Gacathon/LeeChee_Mirror/README.md

# Lisence

CC BY-NC-SA 3.0

# LeeChee_Mirror
Cherry G80&amp;G81-1800 Keyboard layout.Almost both sides place switch.

# Recommend
Please read Readme.docx before assembling.
