Gacathon/LeeChee_Mirror/1800.kicad_pcb

## KiCad design 1800.kicad_pcb (2017-11-04)

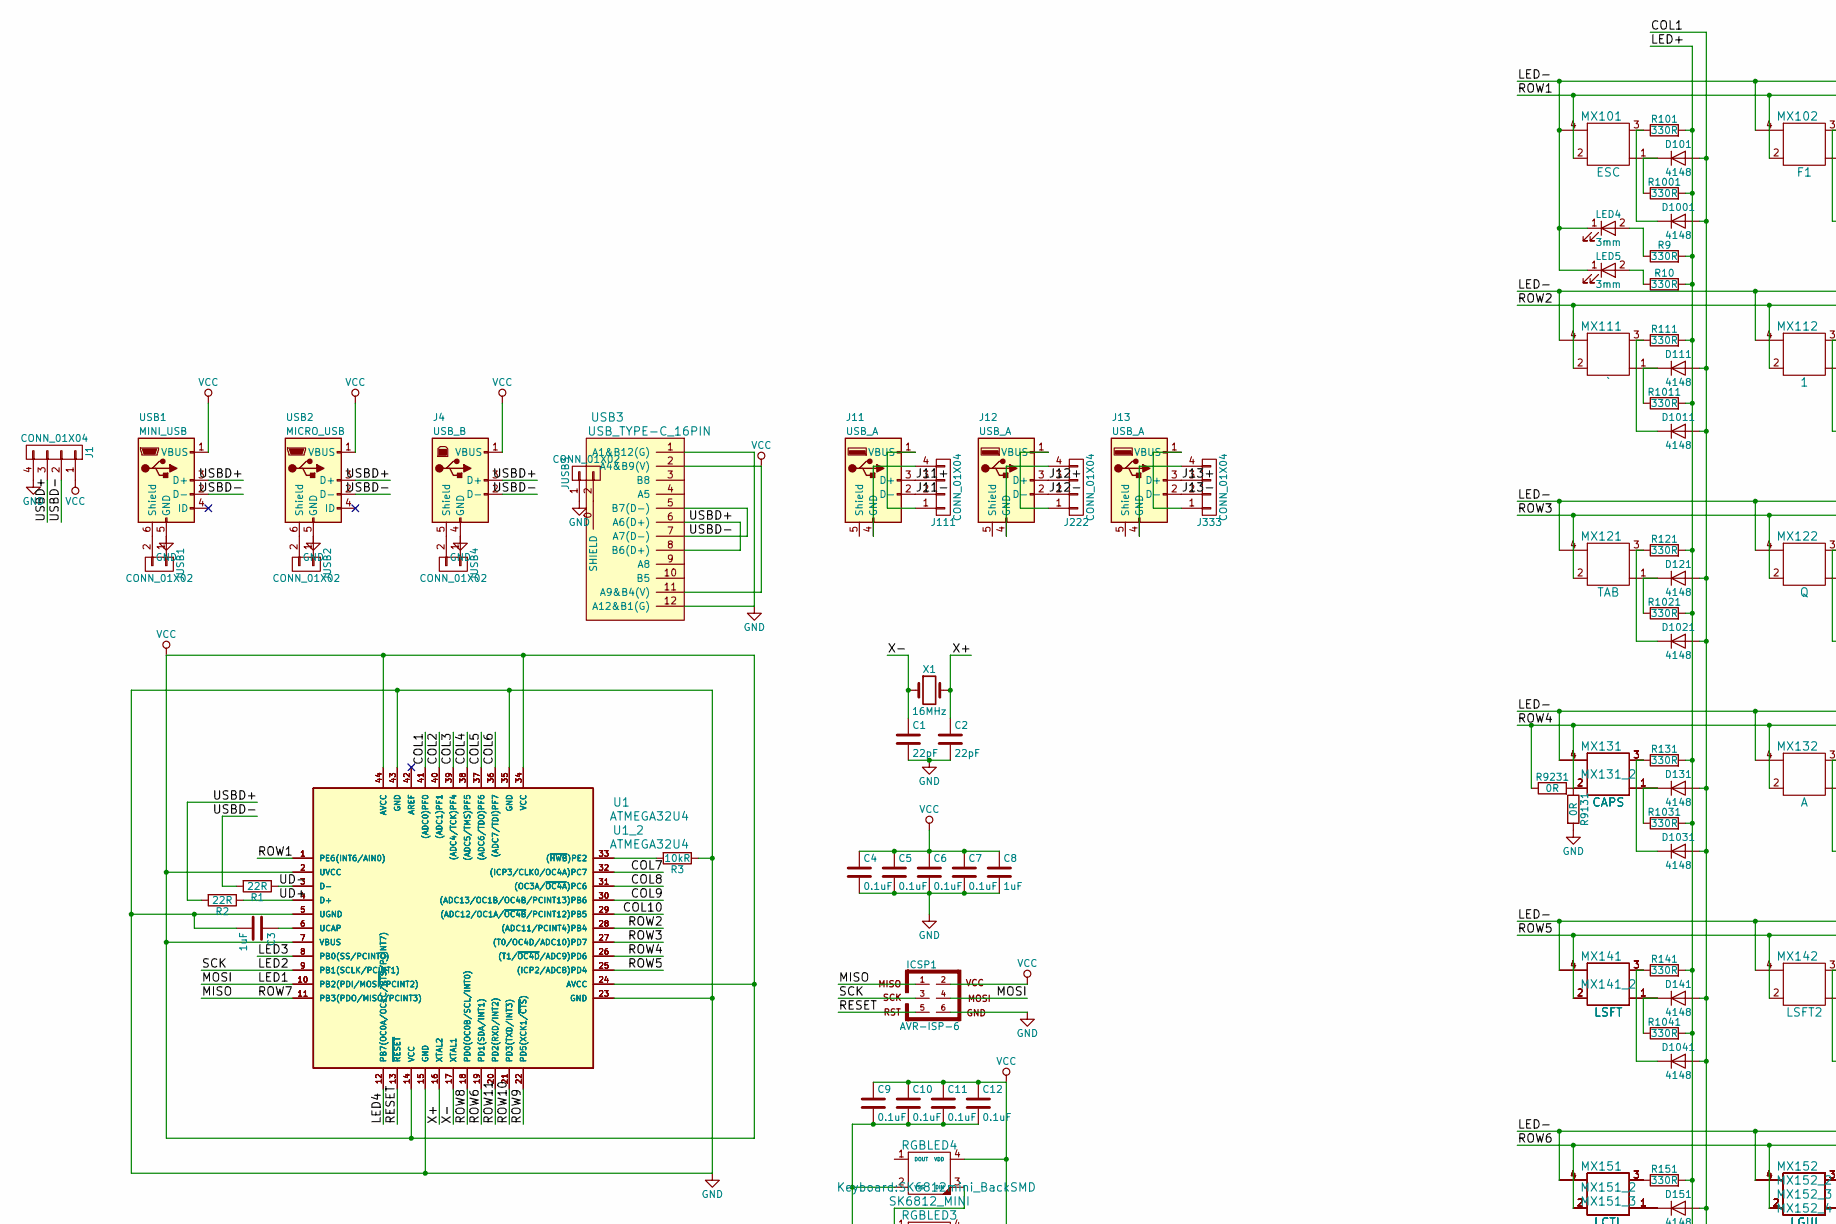
[picture p12: schematic 1800.sch, part in row 1, column 1]

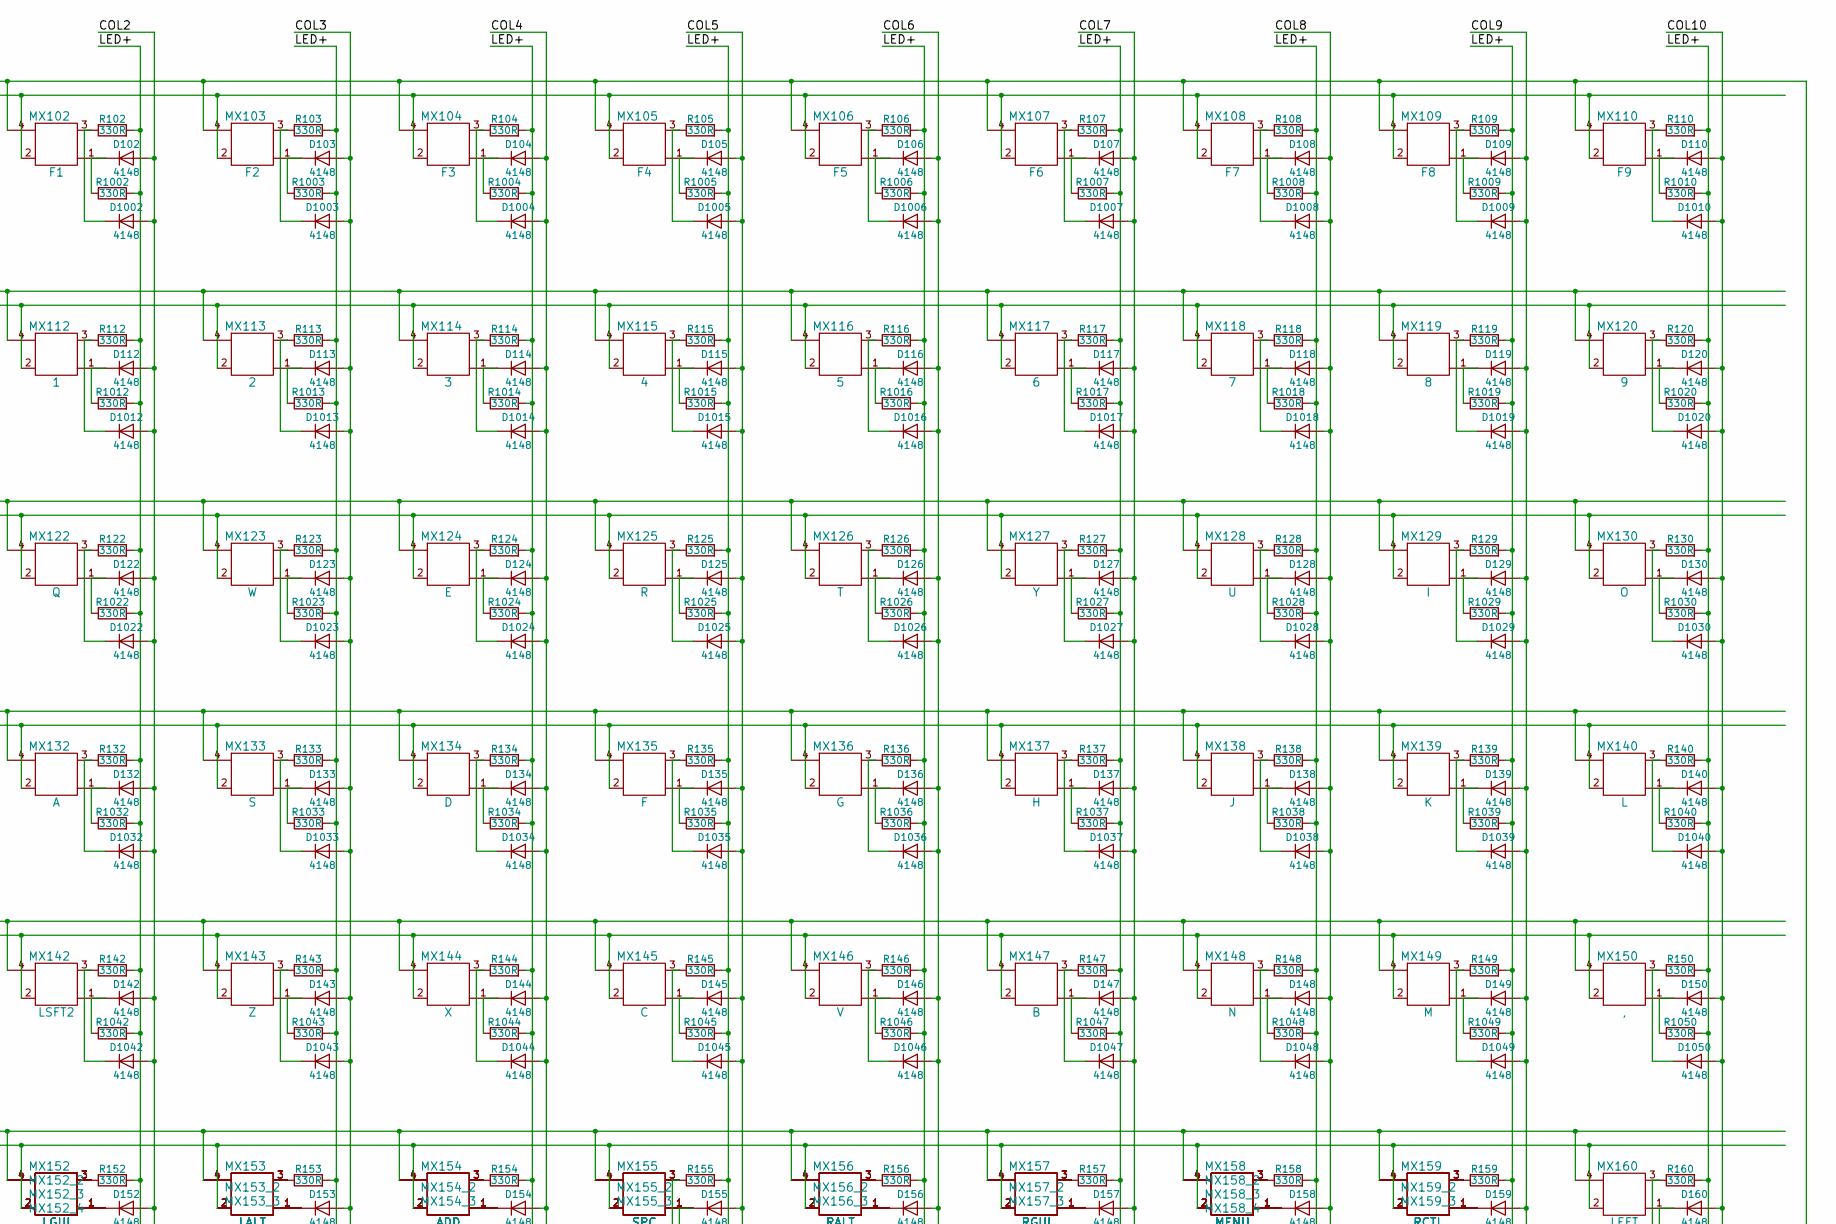
[picture p13: schematic 1800.sch, part in row 1, column 2]

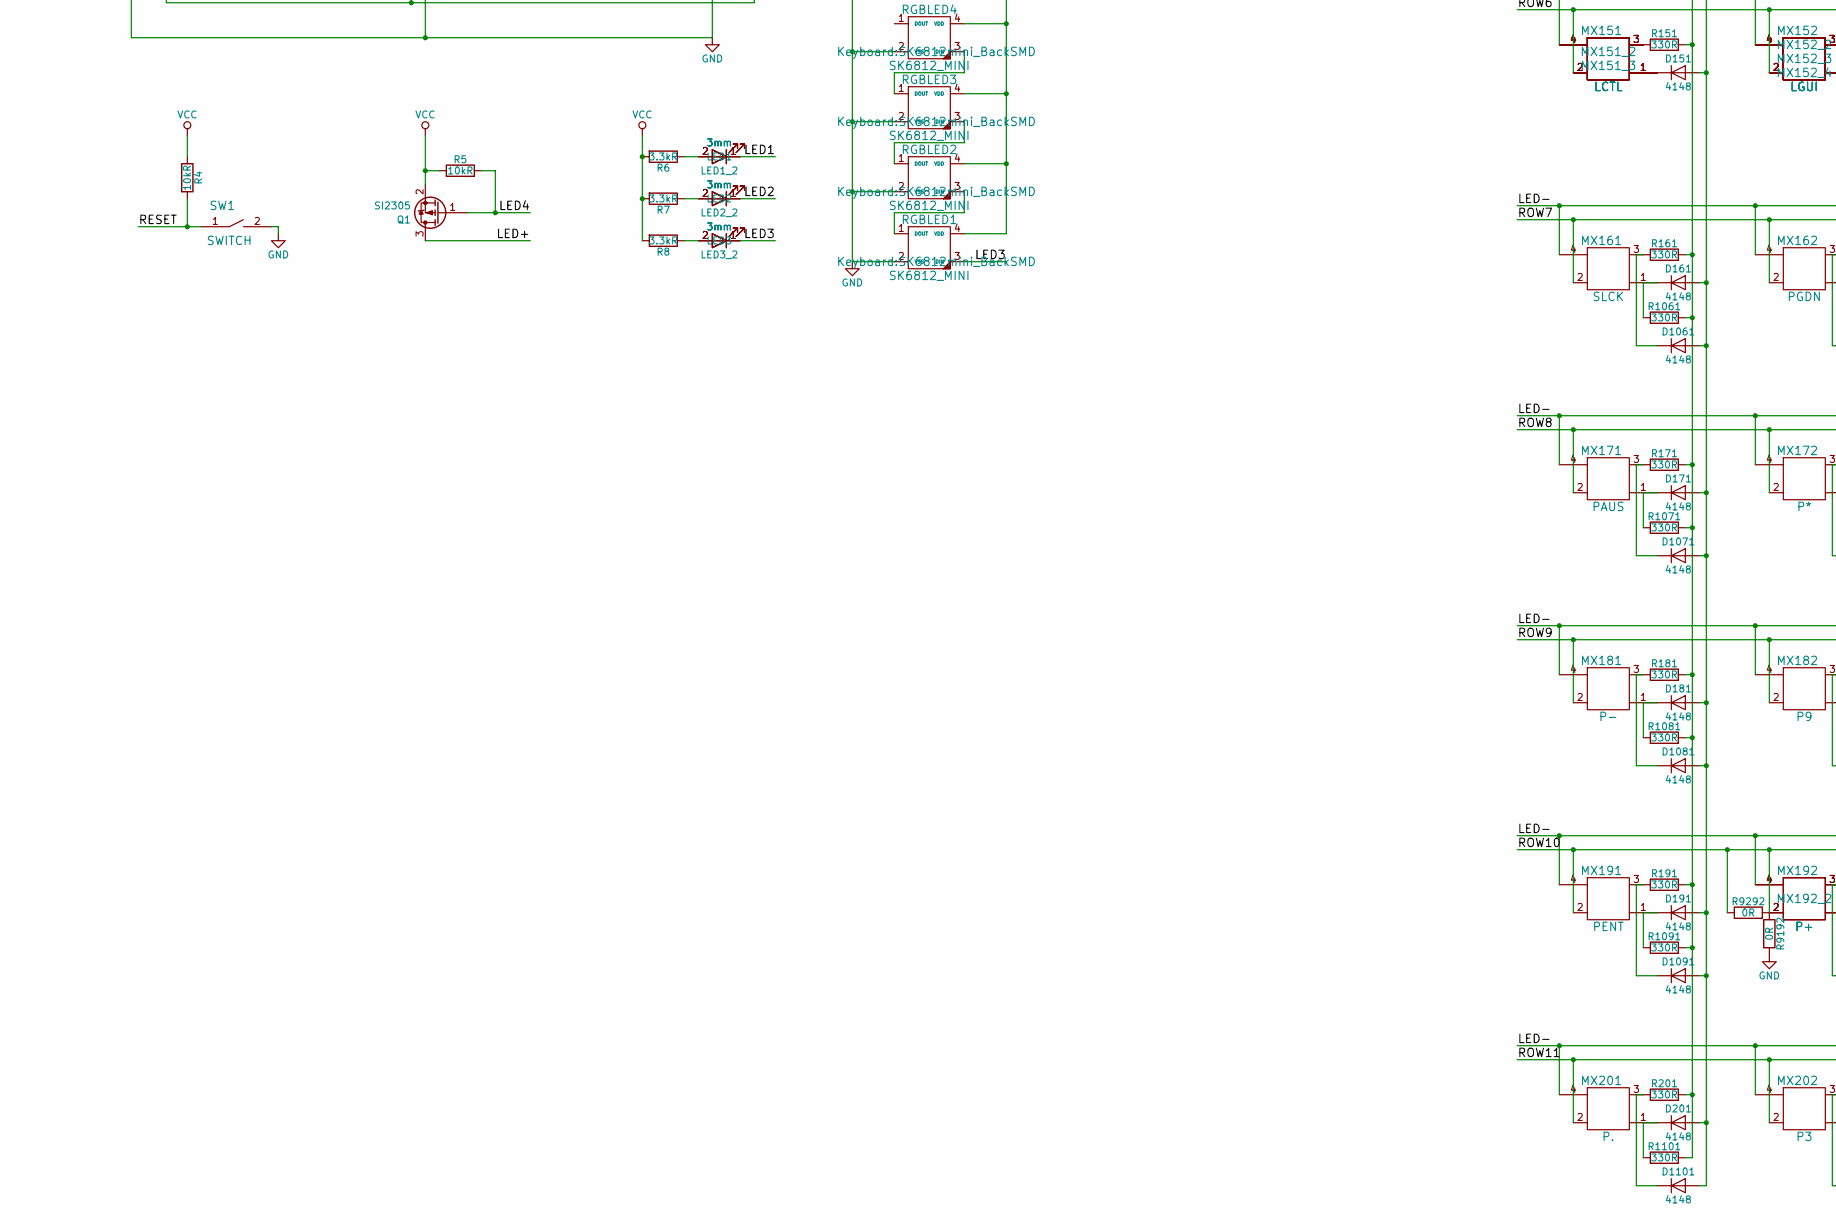
[picture p14: schematic 1800.sch, part in row 2, column 1]

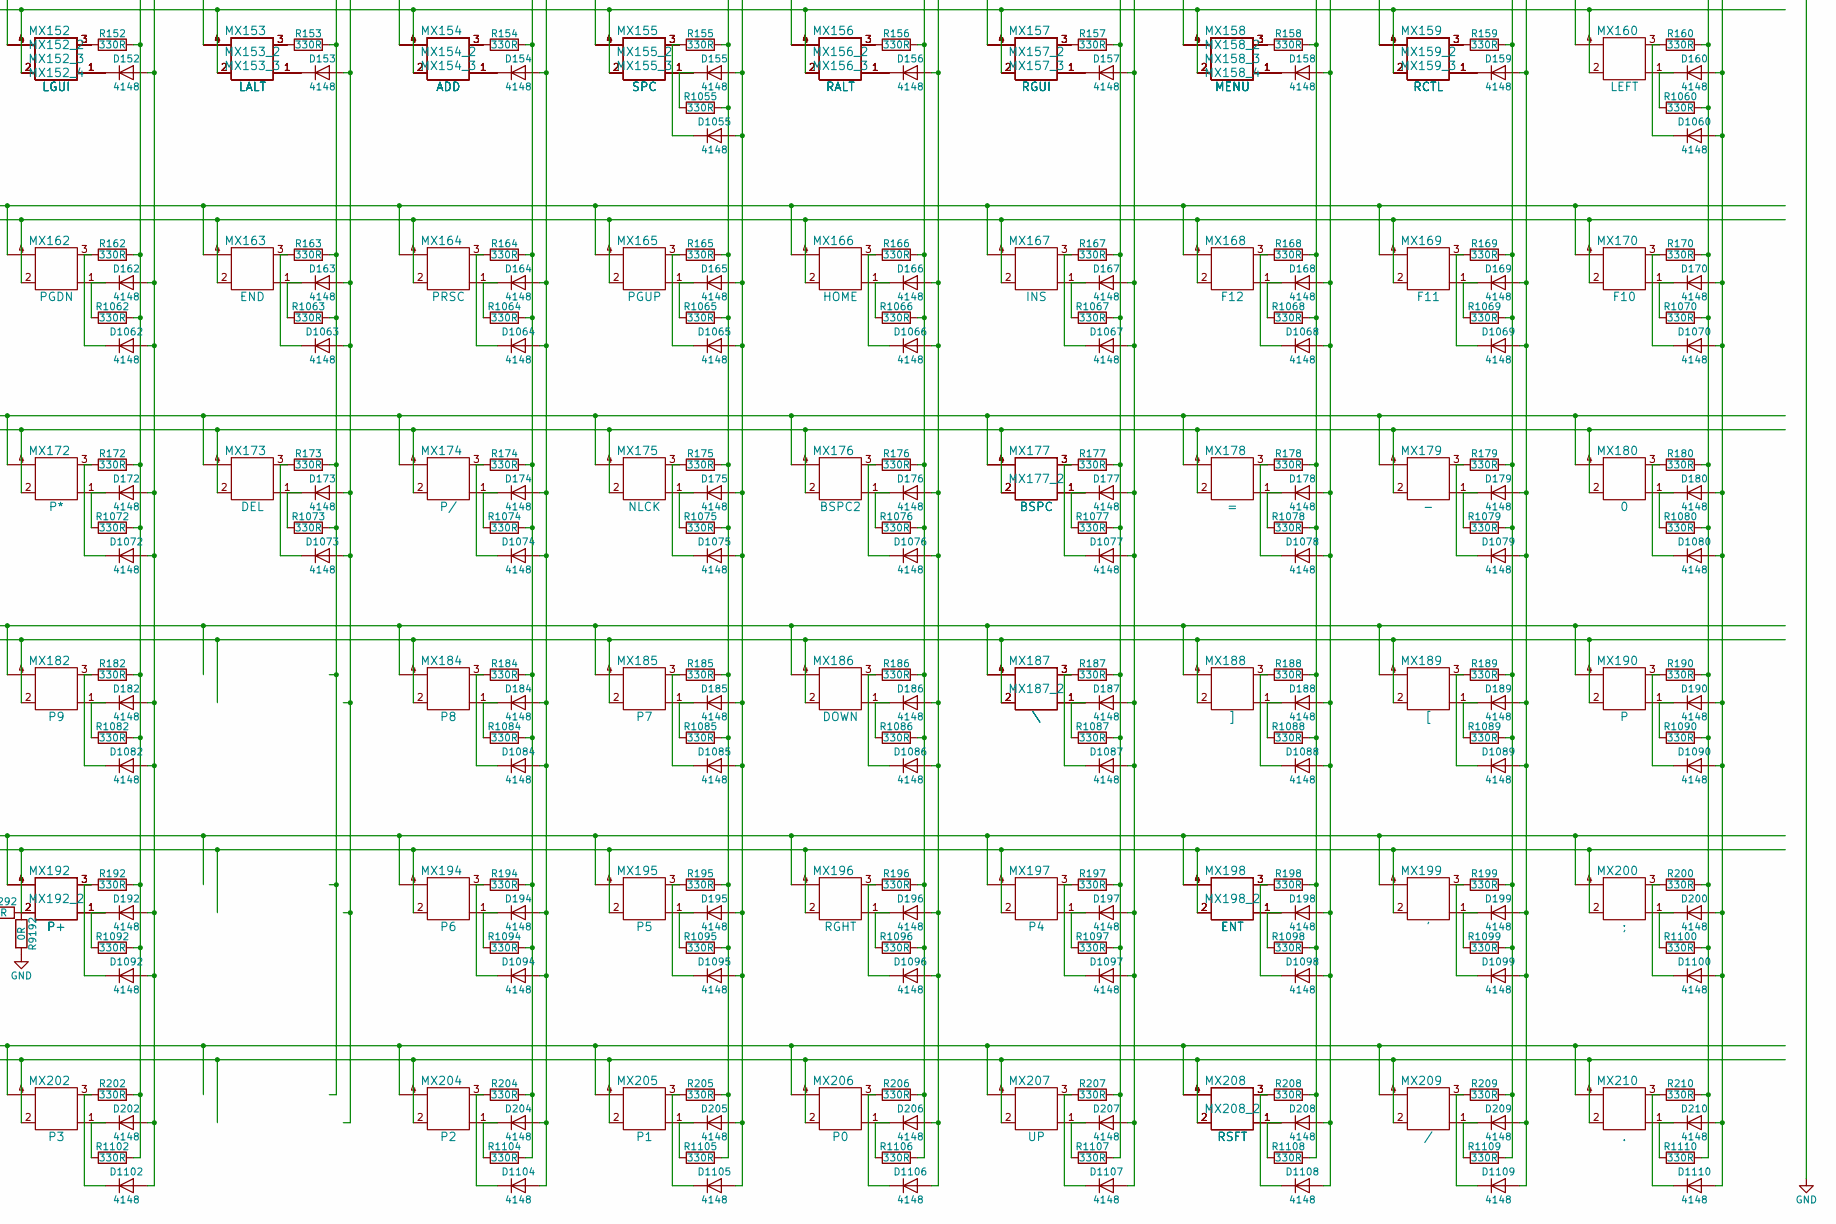
[picture p15: schematic 1800.sch, part in row 2, column 2]

Parts:
C1, C2: 22pF; C_0805
C3, C8: 1uF; C_0805
C4, C5, C6, C7, C9, C10, C11, C12: 0.1uF; C_0805
D101, D102, D103, D104, D105, D106, D107, D108, D109, D110, D111, D112, D113, D114, D115, D116, D117, D118, D119, D120, D121, D122, D123, D124, D125, D126, D127, D128, D129, D130, D131, D132, D133, D134, D135, D136, D137, D138, D139, D140, D141, D142, D143, D144, D145, D146, D147, D148, D149, D150, D151, D152, D153, D154, D155, D156, D157, D158, D159, D160, D161, D162, D163, D164, D165, D166, D167, D168, D169, D170, D171, D172, D173, D174, D175, D176, D177, D178, D179, D180, D181, D182, D184, D185, D186, D187, D188, D189, D190, D191, D192, D194, D195, D196, D197, D198, D199, D200, D201, D202, D204, D205, D206, D207, D208, D209, D210, D1001, D1002, D1003, D1004, D1005, D1006, D1007, D1008, D1009, D1010, D1011, D1012, D1013, D1014, D1015, D1016, D1017, D1018, D1019, D1020, D1021, D1022, D1023, D1024, D1025, D1026, D1027, D1028, D1029, D1030, D1031, D1032, D1033, D1034, D1035, D1036, D1037, D1038, D1039, D1040, D1041, D1042, D1043, D1044, D1045, D1046, D1047, D1048, D1049, D1050, D1055, D1060, D1061, D1062, D1063, D1064, D1065, D1066, D1067, D1068, D1069, D1070, D1071, D1072, D1073, D1074, D1075, D1076, D1077, D1078, D1079, D1080, D1081, D1082, D1084, D1085, D1086, D1087, D1088, D1089, D1090, D1091, D1092, D1094, D1095, D1096, D1097, D1098, D1099, D1100, D1101, D1102, D1104, D1105, D1106, D1107, D1108, D1109, D1110: 4148; D_0805
ICSP1: AVR-ISP-6; Pin_Header_Straight_2x03_Pitch2.54mm
J1, J111, J222, J333: CONN_01X04; Pin_Header_Straight_1x04_Pitch2.54mm
J4: USB_B
J11, J12, J13: USB_A; USB_A_2
JUSB1, JUSB2, JUSB3, JUSB4: CONN_01X02; Pin_Header_Straight_1x02_Pitch1.27mm
LED1, LED1_2, LED2, LED2_2, LED3, LED3_2, LED4, LED5: 3mm; LED_D3.0mm
MX101: ESC; MX1A&LEDx2
MX102: F1; MX1A&LEDx2
MX103: F2; MX1A&LEDx2
MX104: F3; MX1A&LEDx2
MX105: F4; MX1A&LEDx2
MX106: F5; MX1A&LEDx2
MX107: F6; MX1A&LEDx2
MX108: F7; MX1A&LEDx2
MX109: F8; MX1A&LEDx2
MX110: F9; MX1A&LEDx2
MX111: `; MX1A&LEDx2
MX112: 1; MX1A&LEDx2
MX113: 2; MX1A&LEDx2
MX114: 3; MX1A&LEDx2
MX115: 4; MX1A&LEDx2
MX116: 5; MX1A&LEDx2
MX117: 6; MX1A&LEDx2
MX118: 7; MX1A&LEDx2
MX119: 8; MX1A&LEDx2
MX120: 9; MX1A&LEDx2
MX121: TAB; MX1A&LEDx2
MX122: Q; MX1A&LEDx2
MX123: W; MX1A&LEDx2
MX124: E; MX1A&LEDx2
MX125: R; MX1A&LEDx2
MX126: T; MX1A&LEDx2
MX127: Y; MX1A&LEDx2
MX128: U; MX1A&LEDx2
MX129: I; MX1A&LEDx2
MX130: O; MX1A&LEDx2
MX131, MX131_2: CAPS; MX1A&LEDx2
MX132: A; MX1A&LEDx2
MX133: S; MX1A&LEDx2
MX134: D; MX1A&LEDx2
MX135: F; MX1A&LEDx2
MX136: G; MX1A&LEDx2
MX137: H; MX1A&LEDx2
MX138: J; MX1A&LEDx2
MX139: K; MX1A&LEDx2
MX140: L; MX1A&LEDx2
MX141, MX141_2: LSFT; MX1A&LEDx2
MX142: LSFT2; MX1A&LEDx2
MX143: Z; MX1A&LEDx2
MX144: X; MX1A&LEDx2
MX145: C; MX1A&LEDx2
MX146: V; MX1A&LEDx2
MX147: B; MX1A&LEDx2
MX148: N; MX1A&LEDx2
MX149: M; MX1A&LEDx2
MX150: ,; MX1A&LEDx2
MX151, MX151_2, MX151_3: LCTL; MX1A&LED
MX152, MX152_2, MX152_3, MX152_4: LGUI; MX1A&LED
MX153, MX153_2, MX153_3: LALT; MX1A&LED
MX154, MX154_2, MX154_3: ADD; MX1A&LED
MX155, MX155_2, MX155_3: SPC; MX1A&LEDx2
MX156, MX156_2, MX156_3: RALT; MX1A&LED
MX157, MX157_2, MX157_3: RGUI; MX1A&LED
MX158, MX158_2, MX158_3, MX158_4: MENU; MX1A&LED
MX159, MX159_2, MX159_3: RCTL; MX1A&LED
MX160: LEFT; MX1A&LEDx2
MX161: SLCK; MX1A&LEDx2
MX162: PGDN; MX1A&LEDx2
MX163: END; MX1A&LEDx2
MX164: PRSC; MX1A&LEDx2
MX165: PGUP; MX1A&LEDx2
MX166: HOME; MX1A&LEDx2
MX167: INS; MX1A&LEDx2
MX168: F12; MX1A&LEDx2
MX169: F11; MX1A&LEDx2
MX170: F10; MX1A&LEDx2
MX171: PAUS; MX1A&LEDx2
MX172: P*; MX1A&LEDx2
MX173: DEL; MX1A&LEDx2
MX174: P/; MX1A&LEDx2
MX175: NLCK; MX1A&LEDx2
MX176: BSPC2; MX1A&LEDx2
MX177, MX177_2: BSPC; MX1A&LEDx2
MX178: =; MX1A&LEDx2
MX179: -; MX1A&LEDx2
MX180: 0; MX1A&LEDx2
MX181: P-; MX1A&LEDx2
MX182: P9; MX1A&LEDx2
MX184: P8; MX1A&LEDx2
MX185: P7; MX1A&LEDx2
MX186: DOWN; MX1A&LEDx2
MX187, MX187_2: \\; MX1A&LEDx2
MX188: ]; MX1A&LEDx2
MX189: [; MX1A&LEDx2
MX190: P; MX1A&LEDx2
MX191: PENT; MX1A&LEDx2
MX192, MX192_2: P+; MX1A&LEDx2
MX194: P6; MX1A&LEDx2
MX195: P5; MX1A&LEDx2
MX196: RGHT; MX1A&LEDx2
MX197: P4; MX1A&LEDx2
MX198, MX198_2: ENT; MX1A&LEDx2
MX199: '; MX1A&LEDx2
MX200: ;; MX1A&LEDx2
MX201: P.; MX1A&LEDx2
MX202: P3; MX1A&LEDx2
MX204: P2; MX1A&LEDx2
MX205: P1; MX1A&LEDx2
MX206: P0; MX1A&LEDx2
MX207: UP; MX1A&LEDx2
MX208, MX208_2: RSFT; MX1A&LEDx2
MX209: /; MX1A&LEDx2
MX210: .; MX1A&LEDx2
Q1: SI2305; SOT-23
R1, R2: 22R; R_0805
R3, R4, R5: 10kR; R_0805
R6, R7, R8: 3.3kR; R_0805
R9, R10, R101, R102, R103, R104, R105, R106, R107, R108, R109, R110, R111, R112, R113, R114, R115, R116, R117, R118, R119, R120, R121, R122, R123, R124, R125, R126, R127, R128, R129, R130, R131, R132, R133, R134, R135, R136, R137, R138, R139, R140, R141, R142, R143, R144, R145, R146, R147, R148, R149, R150, R151, R152, R153, R154, R155, R156, R157, R158, R159, R160, R161, R162, R163, R164, R165, R166, R167, R168, R169, R170, R171, R172, R173, R174, R175, R176, R177, R178, R179, R180, R181, R182, R184, R185, R186, R187, R188, R189, R190, R191, R192, R194, R195, R196, R197, R198, R199, R200, R201, R202, R204, R205, R206, R207, R208, R209, R210, R1001, R1002, R1003, R1004, R1005, R1006, R1007, R1008, R1009, R1010, R1011, R1012, R1013, R1014, R1015, R1016, R1017, R1018, R1019, R1020, R1021, R1022, R1023, R1024, R1025, R1026, R1027, R1028, R1029, R1030, R1031, R1032, R1033, R1034, R1035, R1036, R1037, R1038, R1039, R1040, R1041, R1042, R1043, R1044, R1045, R1046, R1047, R1048, R1049, R1050, R1055, R1060, R1061, R1062, R1063, R1064, R1065, R1066, R1067, R1068, R1069, R1070, R1071, R1072, R1073, R1074, R1075, R1076, R1077, R1078, R1079, R1080, R1081, R1082, R1084, R1085, R1086, R1087, R1088, R1089, R1090, R1091, R1092, R1094, R1095, R1096, R1097, R1098, R1099, R1100, R1101, R1102, R1104, R1105, R1106, R1107, R1108, R1109, R1110: 330R; R_0805
R9131, R9192, R9231, R9292: 0R; R_0805
RGBLED1, RGBLED2, RGBLED3, RGBLED4: SK6812_MINI; SK6812mini_BackSMD
SW1: SWITCH; SWITCH-3X6X2.5_SMD+
U1: ATMEGA32U4; TQFP-44_10x10mm_Pitch0.8mm
U1_2: ATMEGA32U4; QFN-44_7x7mm_Pitch0.5mm
USB1: MINI_USB; USB_MINI_4FOOT
USB2: MICRO_USB; USB_MICRO_4FOOT
USB3: USB_TYPE-C_16PIN
X1: 16MHz; Crystal_SMD_5032-2pin_5.0x3.2mm

Connections:
/COL1: D101.2 (A), D111.2 (A), D121.2 (A), D131.2 (A), D141.2 (A), D151.2 (A), D161.2 (A), D171.2 (A), D181.2 (A), D191.2 (A), D201.2 (A), D1001.2 (A), D1011.2 (A), D1021.2 (A), D1031.2 (A), D1041.2 (A), D1061.2 (A), D1071.2 (A), D1081.2 (A), D1091.2 (A), D1101.2 (A), U1.41 ((ADC0)PF0), U1_2.41 ((ADC0)PF0)
/COL2: D102.2 (A), D112.2 (A), D122.2 (A), D132.2 (A), D142.2 (A), D152.2 (A), D162.2 (A), D172.2 (A), D182.2 (A), D192.2 (A), D202.2 (A), D1002.2 (A), D1012.2 (A), D1022.2 (A), D1032.2 (A), D1042.2 (A), D1062.2 (A), D1072.2 (A), D1082.2 (A), D1092.2 (A), D1102.2 (A), U1.40 ((ADC1)PF1), U1_2.40 ((ADC1)PF1)
/COL3: D103.2 (A), D113.2 (A), D123.2 (A), D133.2 (A), D143.2 (A), D153.2 (A), D163.2 (A), D173.2 (A), D1003.2 (A), D1013.2 (A), D1023.2 (A), D1033.2 (A), D1043.2 (A), D1063.2 (A), D1073.2 (A), U1.39 ((ADC4/TCK)PF4), U1_2.39 ((ADC4/TCK)PF4)
/COL4: D104.2 (A), D114.2 (A), D124.2 (A), D134.2 (A), D144.2 (A), D154.2 (A), D164.2 (A), D174.2 (A), D184.2 (A), D194.2 (A), D204.2 (A), D1004.2 (A), D1014.2 (A), D1024.2 (A), D1034.2 (A), D1044.2 (A), D1064.2 (A), D1074.2 (A), D1084.2 (A), D1094.2 (A), D1104.2 (A), U1.38 ((ADC5/TMS)PF5), U1_2.38 ((ADC5/TMS)PF5)
/COL5: D105.2 (A), D115.2 (A), D125.2 (A), D135.2 (A), D145.2 (A), D155.2 (A), D165.2 (A), D175.2 (A), D185.2 (A), D195.2 (A), D205.2 (A), D1005.2 (A), D1015.2 (A), D1025.2 (A), D1035.2 (A), D1045.2 (A), D1055.2 (A), D1065.2 (A), D1075.2 (A), D1085.2 (A), D1095.2 (A), D1105.2 (A), U1.37 ((ADC6/TDO)PF6), U1_2.37 ((ADC6/TDO)PF6)
/COL6: D106.2 (A), D116.2 (A), D126.2 (A), D136.2 (A), D146.2 (A), D156.2 (A), D166.2 (A), D176.2 (A), D186.2 (A), D196.2 (A), D206.2 (A), D1006.2 (A), D1016.2 (A), D1026.2 (A), D1036.2 (A), D1046.2 (A), D1066.2 (A), D1076.2 (A), D1086.2 (A), D1096.2 (A), D1106.2 (A), U1.36 ((ADC7/TDI)PF7), U1_2.36 ((ADC7/TDI)PF7)
/COL7: D107.2 (A), D117.2 (A), D127.2 (A), D137.2 (A), D147.2 (A), D157.2 (A), D167.2 (A), D177.2 (A), D187.2 (A), D197.2 (A), D207.2 (A), D1007.2 (A), D1017.2 (A), D1027.2 (A), D1037.2 (A), D1047.2 (A), D1067.2 (A), D1077.2 (A), D1087.2 (A), D1097.2 (A), D1107.2 (A), U1.32 ((ICP3/CLK0/OC4A)PC7), U1_2.32 ((ICP3/CLK0/OC4A)PC7)
/COL8: D108.2 (A), D118.2 (A), D128.2 (A), D138.2 (A), D148.2 (A), D158.2 (A), D168.2 (A), D178.2 (A), D188.2 (A), D198.2 (A), D208.2 (A), D1008.2 (A), D1018.2 (A), D1028.2 (A), D1038.2 (A), D1048.2 (A), D1068.2 (A), D1078.2 (A), D1088.2 (A), D1098.2 (A), D1108.2 (A), U1.31 ((OC3A/~OC4A~)PC6), U1_2.31 ((OC3A/~OC4A~)PC6)
/COL9: D109.2 (A), D119.2 (A), D129.2 (A), D139.2 (A), D149.2 (A), D159.2 (A), D169.2 (A), D179.2 (A), D189.2 (A), D199.2 (A), D209.2 (A), D1009.2 (A), D1019.2 (A), D1029.2 (A), D1039.2 (A), D1049.2 (A), D1069.2 (A), D1079.2 (A), D1089.2 (A), D1099.2 (A), D1109.2 (A), U1.30 ((ADC13/OC1B/OC4B/PCINT13)PB6), U1_2.30 ((ADC13/OC1B/OC4B/PCINT13)PB6)
/COL10: D110.2 (A), D120.2 (A), D130.2 (A), D140.2 (A), D150.2 (A), D160.2 (A), D170.2 (A), D180.2 (A), D190.2 (A), D200.2 (A), D210.2 (A), D1010.2 (A), D1020.2 (A), D1030.2 (A), D1040.2 (A), D1050.2 (A), D1060.2 (A), D1070.2 (A), D1080.2 (A), D1090.2 (A), D1100.2 (A), D1110.2 (A), U1.29 ((ADC12/OC1A/~OC4B~/PCINT12)PB5), U1_2.29 ((ADC12/OC1A/~OC4B~/PCINT12)PB5)
/J11+: J11.3 (D+), J111.3
/J11-: J11.2 (D-), J111.2
/J12+: J12.3 (D+), J222.3
/J12-: J12.2 (D-), J222.2
/J13+: J13.3 (D+), J333.3
/J13-: J13.2 (D-), J333.2
/LED1: ICSP1.4, LED1.1 (K), LED1_2.1 (K), U1.10 (PB2(PDI/MOSI/PCINT2)), U1_2.10 (PB2(PDI/MOSI/PCINT2))
/LED2: ICSP1.3, LED2.1 (K), LED2_2.1 (K), U1.9 (PB1(SCLK/PCINT1)), U1_2.9 (PB1(SCLK/PCINT1))
/LED3: LED3.1 (K), LED3_2.1 (K), RGBLED1.3 (DIN), U1.8 (PB0(SS/PCINT0)), U1_2.8 (PB0(SS/PCINT0))
/LED4: Q1.1 (G), R5.2, U1.12 (PB7(OC0A/OC1C/~RTS~/PCINT7)), U1_2.12 (PB7(OC0A/OC1C/~RTS~/PCINT7))
/LED+: Q1.3 (D), R9.2, R10.2, R101.2, R102.2, R103.2, R104.2, R105.2, R106.2, R107.2, R108.2, R109.2, R110.2, R111.2, R112.2, R113.2, R114.2, R115.2, R116.2, R117.2, R118.2, R119.2, R120.2, R121.2, R122.2, R123.2, R124.2, R125.2, R126.2, R127.2, R128.2, R129.2, R130.2, R131.2, R132.2, R133.2, R134.2, R135.2, R136.2, R137.2, R138.2, R139.2, R140.2, R141.2, R142.2, R143.2, R144.2, R145.2, R146.2, R147.2, R148.2, R149.2, R150.2, R151.2, R152.2, R153.2, R154.2, R155.2, R156.2, R157.2, R158.2, R159.2, R160.2, R161.2, R162.2, R163.2, R164.2, R165.2, R166.2, R167.2, R168.2, R169.2, R170.2, R171.2, R172.2, R173.2, R174.2, R175.2, R176.2, R177.2, R178.2, R179.2, R180.2, R181.2, R182.2, R184.2, R185.2, R186.2, R187.2, R188.2, R189.2, R190.2, R191.2, R192.2, R194.2, R195.2, R196.2, R197.2, R198.2, R199.2, R200.2, R201.2, R202.2, R204.2, R205.2, R206.2, R207.2, R208.2, R209.2, R210.2, R1001.2, R1002.2, R1003.2, R1004.2, R1005.2, R1006.2, R1007.2, R1008.2, R1009.2, R1010.2, R1011.2, R1012.2, R1013.2, R1014.2, R1015.2, R1016.2, R1017.2, R1018.2, R1019.2, R1020.2, R1021.2, R1022.2, R1023.2, R1024.2, R1025.2, R1026.2, R1027.2, R1028.2, R1029.2, R1030.2, R1031.2, R1032.2, R1033.2, R1034.2, R1035.2, R1036.2, R1037.2, R1038.2, R1039.2, R1040.2, R1041.2, R1042.2, R1043.2, R1044.2, R1045.2, R1046.2, R1047.2, R1048.2, R1049.2, R1050.2, R1055.2, R1060.2, R1061.2, R1062.2, R1063.2, R1064.2, R1065.2, R1066.2, R1067.2, R1068.2, R1069.2, R1070.2, R1071.2, R1072.2, R1073.2, R1074.2, R1075.2, R1076.2, R1077.2, R1078.2, R1079.2, R1080.2, R1081.2, R1082.2, R1084.2, R1085.2, R1086.2, R1087.2, R1088.2, R1089.2, R1090.2, R1091.2, R1092.2, R1094.2, R1095.2, R1096.2, R1097.2, R1098.2, R1099.2, R1100.2, R1101.2, R1102.2, R1104.2, R1105.2, R1106.2, R1107.2, R1108.2, R1109.2, R1110.2
/MISO: ICSP1.1, MX161.2, MX162.2, MX163.2, MX164.2, MX165.2, MX166.2, MX167.2, MX168.2, MX169.2, MX170.2, U1.11 (PB3(PDO/MISO/PCINT3)), U1_2.11 (PB3(PDO/MISO/PCINT3))
/RESET: ICSP1.5, R4.2, SW1.1, U1.13 (~RESET~), U1_2.13 (~RESET~)
/ROW1: MX101.2, MX102.2, MX103.2, MX104.2, MX105.2, MX106.2, MX107.2, MX108.2, MX109.2, MX110.2, U1.1 (PE6(INT6/AIN0)), U1_2.1 (PE6(INT6/AIN0))
/ROW2: MX111.2, MX112.2, MX113.2, MX114.2, MX115.2, MX116.2, MX117.2, MX118.2, MX119.2, MX120.2, U1.28 ((ADC11/PCINT4)PB4), U1_2.28 ((ADC11/PCINT4)PB4)
/ROW3: MX121.2, MX122.2, MX123.2, MX124.2, MX125.2, MX126.2, MX127.2, MX128.2, MX129.2, MX130.2, U1.27 ((T0/OC4D/ADC10)PD7), U1_2.27 ((T0/OC4D/ADC10)PD7)
/ROW4: MX131.2, MX131_2.2, MX132.2, MX133.2, MX134.2, MX135.2, MX136.2, MX137.2, MX138.2, MX139.2, MX140.2, R9131.1, R9231.1, R9231.2, U1.26 ((T1/~OC4D~/ADC9)PD6), U1_2.26 ((T1/~OC4D~/ADC9)PD6)
/ROW5: MX141.2, MX141_2.2, MX142.2, MX143.2, MX144.2, MX145.2, MX146.2, MX147.2, MX148.2, MX149.2, MX150.2, U1.25 ((ICP2/ADC8)PD4), U1_2.25 ((ICP2/ADC8)PD4)
/ROW6: MX151.2, MX151_2.2, MX151_3.2, MX152.2, MX152_2.2, MX152_3.2, MX152_4.2, MX153.2, MX153_2.2, MX153_3.2, MX154.2, MX154_2.2, MX154_3.2, MX155.2, MX155_2.2, MX155_3.2, MX156.2, MX156_2.2, MX156_3.2, MX157.2, MX157_2.2, MX157_3.2, MX158.2, MX158_2.2, MX158_3.2, MX158_4.2, MX159.2, MX159_2.2, MX159_3.2, MX160.2, U1.19 (PD1(SDA/INT1)), U1_2.19 (PD1(SDA/INT1))
/ROW8: MX171.2, MX172.2, MX173.2, MX174.2, MX175.2, MX176.2, MX177.2, MX177_2.2, MX178.2, MX179.2, MX180.2, U1.18 (PD0(OC0B/SCL/INT0)), U1_2.18 (PD0(OC0B/SCL/INT0))
/ROW9: MX181.2, MX182.2, MX184.2, MX185.2, MX186.2, MX187.2, MX187_2.2, MX188.2, MX189.2, MX190.2, U1.22 (PD5(XCK1/~CTS~)), U1_2.22 (PD5(XCK1/~CTS~))
/ROW10: MX191.2, MX192.2, MX192_2.2, MX194.2, MX195.2, MX196.2, MX197.2, MX198.2, MX198_2.2, MX199.2, MX200.2, R9192.1, R9292.1, R9292.2, U1.21 (PD3(TXD/INT3)), U1_2.21 (PD3(TXD/INT3))
/ROW11: MX201.2, MX202.2, MX204.2, MX205.2, MX206.2, MX207.2, MX208.2, MX208_2.2, MX209.2, MX210.2, U1.20 (PD2(RXD/INT2)), U1_2.20 (PD2(RXD/INT2))
/UD+: R2.1, U1.4 (D+), U1_2.4 (D+)
/UD-: R1.1, U1.3 (D-), U1_2.3 (D-)
/USBD+: J1.3, J4.3 (D+), R2.2, USB1.3 (D+), USB2.3 (D+), USB3.6 (A6(D+)), USB3.8 (B6(D+)); also elsewhere on the board
/USBD-: J1.2, J4.2 (D-), R1.2, USB1.2 (D-), USB2.2 (D-), USB3.5 (B7(D-)), USB3.7 (A7(D-)); also elsewhere on the board
/X+: C2.1, U1.16 (XTAL2), U1_2.16 (XTAL2), X1.2
/X-: C1.1, U1.17 (XTAL1), U1_2.17 (XTAL1), X1.1
GND: C1.2, C2.2, C3.2, C4.2, C5.2, C6.2, C7.2, C8.2, C9.2, C10.2, C11.2, C12.2, ICSP1.6, J1.4, J4.4 (GND), JUSB1.1, JUSB2.1, JUSB3.1, JUSB4.1, LED4.1 (K), LED5.1 (K), MX101.4, MX102.4, MX103.4, MX104.4, MX105.4, MX106.4, MX107.4, MX108.4, MX109.4, MX110.4, MX111.4, MX112.4, MX113.4, MX114.4, MX115.4, MX116.4, MX117.4, MX118.4, MX119.4, MX120.4, MX121.4, MX122.4, MX123.4, MX124.4, MX125.4, MX126.4, MX127.4, MX128.4, MX129.4, MX130.4, MX131.4, MX131_2.4, MX132.4, MX133.4, MX134.4, MX135.4, MX136.4, MX137.4, MX138.4, MX139.4, MX140.4, MX141.4, MX141_2.4, MX142.4, MX143.4, MX144.4, MX145.4, MX146.4, MX147.4, MX148.4, MX149.4, MX150.4, MX151.4, MX151_2.4, MX151_3.4, MX152.4, MX152_2.4, MX152_3.4, MX152_4.4, MX153.4, MX153_2.4, MX153_3.4, MX154.4, MX154_2.4, MX154_3.4, MX155.4, MX155_2.4, MX155_3.4, MX156.4, MX156_2.4, MX156_3.4, MX157.4, MX157_2.4, MX157_3.4, MX158.4, MX158_2.4, MX158_3.4, MX158_4.4, MX159.4, MX159_2.4, MX159_3.4, MX160.4, MX161.4, MX162.4, MX163.4, MX164.4, MX165.4, MX166.4, MX167.4, MX168.4, MX169.4, MX170.4, MX171.4, MX172.4, MX173.4, MX174.4, MX175.4, MX176.4, MX177.4, MX177_2.4, MX178.4, MX179.4, MX180.4, MX181.4, MX182.4, MX184.4, MX185.4, MX186.4, MX187.4, MX187_2.4, MX188.4, MX189.4, MX190.4, MX191.4, MX192.4, MX192_2.4, MX194.4, MX195.4, MX196.4, MX197.4, MX198.4, MX198_2.4, MX199.4, MX200.4, MX201.4, MX202.4, MX204.4, MX205.4, MX206.4, MX207.4, MX208.4, MX208_2.4, MX209.4, MX210.4, R3.1, R9131.2, R9192.2, RGBLED1.2 (VSS), RGBLED2.2 (VSS), RGBLED3.2 (VSS), RGBLED4.2 (VSS), SW1.2, U1.5 (UGND), U1.15 (GND), U1.23 (GND), U1.35 (GND), U1.43 (GND), U1_2.5 (UGND), U1_2.15 (GND), U1_2.23 (GND), U1_2.35 (GND), U1_2.43 (GND), USB1.5 (GND), USB2.5 (GND), USB3.1 (A1&B12(G)), USB3.12 (A12&B1(G)); also elsewhere on the board
unnamed: C3.1, U1.6 (UCAP), U1_2.6 (UCAP)
unnamed: D101.1 (K), MX101.1, R1001.1
unnamed: D102.1 (K), MX102.1, R1002.1
unnamed: D103.1 (K), MX103.1, R1003.1
unnamed: D104.1 (K), MX104.1, R1004.1
unnamed: D105.1 (K), MX105.1, R1005.1
unnamed: D106.1 (K), MX106.1, R1006.1
unnamed: D107.1 (K), MX107.1, R1007.1
unnamed: D108.1 (K), MX108.1, R1008.1
unnamed: D109.1 (K), MX109.1, R1009.1
unnamed: D110.1 (K), MX110.1, R1010.1
unnamed: D111.1 (K), MX111.1, R1011.1
unnamed: D112.1 (K), MX112.1, R1012.1
unnamed: D113.1 (K), MX113.1, R1013.1
unnamed: D114.1 (K), MX114.1, R1014.1
unnamed: D115.1 (K), MX115.1, R1015.1
unnamed: D116.1 (K), MX116.1, R1016.1
unnamed: D117.1 (K), MX117.1, R1017.1
unnamed: D118.1 (K), MX118.1, R1018.1
unnamed: D119.1 (K), MX119.1, R1019.1
unnamed: D120.1 (K), MX120.1, R1020.1
unnamed: D121.1 (K), MX121.1, R1021.1
unnamed: D122.1 (K), MX122.1, R1022.1
unnamed: D123.1 (K), MX123.1, R1023.1
unnamed: D124.1 (K), MX124.1, R1024.1
unnamed: D125.1 (K), MX125.1, R1025.1
unnamed: D126.1 (K), MX126.1, R1026.1
unnamed: D127.1 (K), MX127.1, R1027.1
unnamed: D128.1 (K), MX128.1, R1028.1
unnamed: D129.1 (K), MX129.1, R1029.1
unnamed: D130.1 (K), MX130.1, R1030.1
unnamed: D131.1 (K), MX131.1, MX131_2.1, R1031.1
unnamed: D132.1 (K), MX132.1, R1032.1
unnamed: D133.1 (K), MX133.1, R1033.1
unnamed: D134.1 (K), MX134.1, R1034.1
unnamed: D135.1 (K), MX135.1, R1035.1
unnamed: D136.1 (K), MX136.1, R1036.1
unnamed: D137.1 (K), MX137.1, R1037.1
unnamed: D138.1 (K), MX138.1, R1038.1
unnamed: D139.1 (K), MX139.1, R1039.1
unnamed: D140.1 (K), MX140.1, R1040.1
unnamed: D141.1 (K), MX141.1, MX141_2.1, R1041.1
unnamed: D142.1 (K), MX142.1, R1042.1
unnamed: D143.1 (K), MX143.1, R1043.1
unnamed: D144.1 (K), MX144.1, R1044.1
unnamed: D145.1 (K), MX145.1, R1045.1
unnamed: D146.1 (K), MX146.1, R1046.1
unnamed: D147.1 (K), MX147.1, R1047.1
unnamed: D148.1 (K), MX148.1, R1048.1
unnamed: D149.1 (K), MX149.1, R1049.1
unnamed: D150.1 (K), MX150.1, R1050.1
unnamed: D151.1 (K), MX151.1, MX151_2.1, MX151_3.1
unnamed: D152.1 (K), MX152.1, MX152_2.1, MX152_3.1, MX152_4.1
unnamed: D153.1 (K), MX153.1, MX153_2.1, MX153_3.1
unnamed: D154.1 (K), MX154.1, MX154_2.1, MX154_3.1
unnamed: D155.1 (K), MX155.1, MX155_2.1, MX155_3.1, R1055.1
unnamed: D156.1 (K), MX156.1, MX156_2.1, MX156_3.1
unnamed: D157.1 (K), MX157.1, MX157_2.1, MX157_3.1
unnamed: D158.1 (K), MX158.1, MX158_2.1, MX158_3.1, MX158_4.1
unnamed: D159.1 (K), MX159.1, MX159_2.1, MX159_3.1
unnamed: D160.1 (K), MX160.1, R1060.1
unnamed: D161.1 (K), MX161.1, R1061.1
unnamed: D162.1 (K), MX162.1, R1062.1
unnamed: D163.1 (K), MX163.1, R1063.1
unnamed: D164.1 (K), MX164.1, R1064.1
unnamed: D165.1 (K), MX165.1, R1065.1
unnamed: D166.1 (K), MX166.1, R1066.1
unnamed: D167.1 (K), MX167.1, R1067.1
unnamed: D168.1 (K), MX168.1, R1068.1
unnamed: D169.1 (K), MX169.1, R1069.1
unnamed: D170.1 (K), MX170.1, R1070.1
unnamed: D171.1 (K), MX171.1, R1071.1
unnamed: D172.1 (K), MX172.1, R1072.1
unnamed: D173.1 (K), MX173.1, R1073.1
unnamed: D174.1 (K), MX174.1, R1074.1
unnamed: D175.1 (K), MX175.1, R1075.1
unnamed: D176.1 (K), MX176.1, R1076.1
unnamed: D177.1 (K), MX177.1, MX177_2.1, R1077.1
unnamed: D178.1 (K), MX178.1, R1078.1
unnamed: D179.1 (K), MX179.1, R1079.1
unnamed: D180.1 (K), MX180.1, R1080.1
unnamed: D181.1 (K), MX181.1, R1081.1
unnamed: D182.1 (K), MX182.1, R1082.1
unnamed: D184.1 (K), MX184.1, R1084.1
unnamed: D185.1 (K), MX185.1, R1085.1
unnamed: D186.1 (K), MX186.1, R1086.1
unnamed: D187.1 (K), MX187.1, MX187_2.1, R1087.1
unnamed: D188.1 (K), MX188.1, R1088.1
unnamed: D189.1 (K), MX189.1, R1089.1
unnamed: D190.1 (K), MX190.1, R1090.1
unnamed: D191.1 (K), MX191.1, R1091.1
unnamed: D192.1 (K), MX192.1, MX192_2.1, R1092.1
unnamed: D194.1 (K), MX194.1, R1094.1
unnamed: D195.1 (K), MX195.1, R1095.1
unnamed: D196.1 (K), MX196.1, R1096.1
unnamed: D197.1 (K), MX197.1, R1097.1
unnamed: D198.1 (K), MX198.1, MX198_2.1, R1098.1
unnamed: D199.1 (K), MX199.1, R1099.1
unnamed: D200.1 (K), MX200.1, R1100.1
unnamed: D201.1 (K), MX201.1, R1101.1
unnamed: D202.1 (K), MX202.1, R1102.1
unnamed: D204.1 (K), MX204.1, R1104.1
unnamed: D205.1 (K), MX205.1, R1105.1
unnamed: D206.1 (K), MX206.1, R1106.1
unnamed: D207.1 (K), MX207.1, R1107.1
unnamed: D208.1 (K), MX208.1, MX208_2.1, R1108.1
unnamed: D209.1 (K), MX209.1, R1109.1
unnamed: D210.1 (K), MX210.1, R1110.1
unnamed: D1001.1 (K), MX101.3, R101.1
unnamed: D1002.1 (K), MX102.3, R102.1
unnamed: D1003.1 (K), MX103.3, R103.1
unnamed: D1004.1 (K), MX104.3, R104.1
unnamed: D1005.1 (K), MX105.3, R105.1
unnamed: D1006.1 (K), MX106.3, R106.1
unnamed: D1007.1 (K), MX107.3, R107.1
unnamed: D1008.1 (K), MX108.3, R108.1
unnamed: D1009.1 (K), MX109.3, R109.1
unnamed: D1010.1 (K), MX110.3, R110.1
unnamed: D1011.1 (K), MX111.3, R111.1
unnamed: D1012.1 (K), MX112.3, R112.1
unnamed: D1013.1 (K), MX113.3, R113.1
unnamed: D1014.1 (K), MX114.3, R114.1
unnamed: D1015.1 (K), MX115.3, R115.1
unnamed: D1016.1 (K), MX116.3, R116.1
unnamed: D1017.1 (K), MX117.3, R117.1
unnamed: D1018.1 (K), MX118.3, R118.1
unnamed: D1019.1 (K), MX119.3, R119.1
unnamed: D1020.1 (K), MX120.3, R120.1
unnamed: D1021.1 (K), MX121.3, R121.1
unnamed: D1022.1 (K), MX122.3, R122.1
unnamed: D1023.1 (K), MX123.3, R123.1
unnamed: D1024.1 (K), MX124.3, R124.1
unnamed: D1025.1 (K), MX125.3, R125.1
unnamed: D1026.1 (K), MX126.3, R126.1
unnamed: D1027.1 (K), MX127.3, R127.1
unnamed: D1028.1 (K), MX128.3, R128.1
unnamed: D1029.1 (K), MX129.3, R129.1
unnamed: D1030.1 (K), MX130.3, R130.1
unnamed: D1031.1 (K), MX131.3, MX131_2.3, R131.1
unnamed: D1032.1 (K), MX132.3, R132.1
unnamed: D1033.1 (K), MX133.3, R133.1
unnamed: D1034.1 (K), MX134.3, R134.1
unnamed: D1035.1 (K), MX135.3, R135.1
unnamed: D1036.1 (K), MX136.3, R136.1
unnamed: D1037.1 (K), MX137.3, R137.1
unnamed: D1038.1 (K), MX138.3, R138.1
unnamed: D1039.1 (K), MX139.3, R139.1
unnamed: D1040.1 (K), MX140.3, R140.1
unnamed: D1041.1 (K), MX141.3, MX141_2.3, R141.1
unnamed: D1042.1 (K), MX142.3, R142.1
unnamed: D1043.1 (K), MX143.3, R143.1
unnamed: D1044.1 (K), MX144.3, R144.1
unnamed: D1045.1 (K), MX145.3, R145.1
unnamed: D1046.1 (K), MX146.3, R146.1
unnamed: D1047.1 (K), MX147.3, R147.1
unnamed: D1048.1 (K), MX148.3, R148.1
unnamed: D1049.1 (K), MX149.3, R149.1
unnamed: D1050.1 (K), MX150.3, R150.1
unnamed: D1055.1 (K), MX155.3, MX155_2.3, MX155_3.3, R155.1
unnamed: D1060.1 (K), MX160.3, R160.1
unnamed: D1061.1 (K), MX161.3, R161.1
unnamed: D1062.1 (K), MX162.3, R162.1
unnamed: D1063.1 (K), MX163.3, R163.1
unnamed: D1064.1 (K), MX164.3, R164.1
unnamed: D1065.1 (K), MX165.3, R165.1
unnamed: D1066.1 (K), MX166.3, R166.1
unnamed: D1067.1 (K), MX167.3, R167.1
unnamed: D1068.1 (K), MX168.3, R168.1
unnamed: D1069.1 (K), MX169.3, R169.1
unnamed: D1070.1 (K), MX170.3, R170.1
unnamed: D1071.1 (K), MX171.3, R171.1
unnamed: D1072.1 (K), MX172.3, R172.1
unnamed: D1073.1 (K), MX173.3, R173.1
unnamed: D1074.1 (K), MX174.3, R174.1
unnamed: D1075.1 (K), MX175.3, R175.1
unnamed: D1076.1 (K), MX176.3, R176.1
unnamed: D1077.1 (K), MX177.3, MX177_2.3, R177.1
unnamed: D1078.1 (K), MX178.3, R178.1
unnamed: D1079.1 (K), MX179.3, R179.1
unnamed: D1080.1 (K), MX180.3, R180.1
unnamed: D1081.1 (K), MX181.3, R181.1
unnamed: D1082.1 (K), MX182.3, R182.1
unnamed: D1084.1 (K), MX184.3, R184.1
unnamed: D1085.1 (K), MX185.3, R185.1
unnamed: D1086.1 (K), MX186.3, R186.1
unnamed: D1087.1 (K), MX187.3, MX187_2.3, R187.1
unnamed: D1088.1 (K), MX188.3, R188.1
unnamed: D1089.1 (K), MX189.3, R189.1
unnamed: D1090.1 (K), MX190.3, R190.1
unnamed: D1091.1 (K), MX191.3, R191.1
unnamed: D1092.1 (K), MX192.3, MX192_2.3, R192.1
unnamed: D1094.1 (K), MX194.3, R194.1
unnamed: D1095.1 (K), MX195.3, R195.1
unnamed: D1096.1 (K), MX196.3, R196.1
unnamed: D1097.1 (K), MX197.3, R197.1
unnamed: D1098.1 (K), MX198.3, MX198_2.3, R198.1
unnamed: D1099.1 (K), MX199.3, R199.1
unnamed: D1100.1 (K), MX200.3, R200.1
unnamed: D1101.1 (K), MX201.3, R201.1
unnamed: D1102.1 (K), MX202.3, R202.1
unnamed: D1104.1 (K), MX204.3, R204.1
unnamed: D1105.1 (K), MX205.3, R205.1
unnamed: D1106.1 (K), MX206.3, R206.1
unnamed: D1107.1 (K), MX207.3, R207.1
unnamed: D1108.1 (K), MX208.3, MX208_2.3, R208.1
unnamed: D1109.1 (K), MX209.3, R209.1
unnamed: D1110.1 (K), MX210.3, R210.1
unnamed: J4.5 (Shield), JUSB4.2
unnamed: J11.1 (VBUS), J111.1
unnamed: J11.4 (GND), J111.4
unnamed: J12.1 (VBUS), J222.1
unnamed: J12.4 (GND), J222.4
unnamed: J13.1 (VBUS), J333.1
unnamed: J13.4 (GND), J333.4
unnamed: JUSB1.2, USB1.6 (Shield)
unnamed: JUSB2.2, USB2.6 (Shield)
unnamed: JUSB3.2, USB3.0 (SHIELD)
unnamed: LED1.2 (A), LED1_2.2 (A), R6.1
unnamed: LED2.2 (A), LED2_2.2 (A), R7.1
unnamed: LED3.2 (A), LED3_2.2 (A), R8.1
unnamed: LED4.2 (A), R9.1
unnamed: LED5.2 (A), R10.1
unnamed: MX151.3, MX151_2.3, MX151_3.3, R151.1
unnamed: MX152.3, MX152_2.3, MX152_3.3, MX152_4.3, R152.1
unnamed: MX153.3, MX153_2.3, MX153_3.3, R153.1
unnamed: MX154.3, MX154_2.3, MX154_3.3, R154.1
unnamed: MX156.3, MX156_2.3, MX156_3.3, R156.1
unnamed: MX157.3, MX157_2.3, MX157_3.3, R157.1
unnamed: MX158.3, MX158_2.3, MX158_3.3, MX158_4.3, R158.1
unnamed: MX159.3, MX159_2.3, MX159_3.3, R159.1
unnamed: R3.2, U1.33 ((~HWB~)PE2), U1_2.33 ((~HWB~)PE2)
unnamed: RGBLED1.1 (DOUT), RGBLED2.3 (DIN)
unnamed: RGBLED2.1 (DOUT), RGBLED3.3 (DIN)
unnamed: RGBLED3.1 (DOUT), RGBLED4.3 (DIN)
unnamed: U1.42 (AREF), U1_2.42 (AREF)
VCC: C4.1, C5.1, C6.1, C7.1, C8.1, C9.1, C10.1, C11.1, C12.1, ICSP1.2, J1.1, J4.1 (VBUS), Q1.2 (S), R4.1, R5.1, R6.2, R7.2, R8.2, RGBLED1.4 (VDD), RGBLED2.4 (VDD), RGBLED3.4 (VDD), RGBLED4.4 (VDD), U1.2 (UVCC), U1.7 (VBUS), U1.14 (VCC), U1.24 (AVCC), U1.34 (VCC), U1.44 (AVCC), U1_2.2 (UVCC), U1_2.7 (VBUS), U1_2.14 (VCC), U1_2.24 (AVCC), U1_2.34 (VCC), U1_2.44 (AVCC), USB1.1 (VBUS), USB2.1 (VBUS), USB3.2 (A4&B9(V)), USB3.11 (A9&B4(V)); also elsewhere on the board

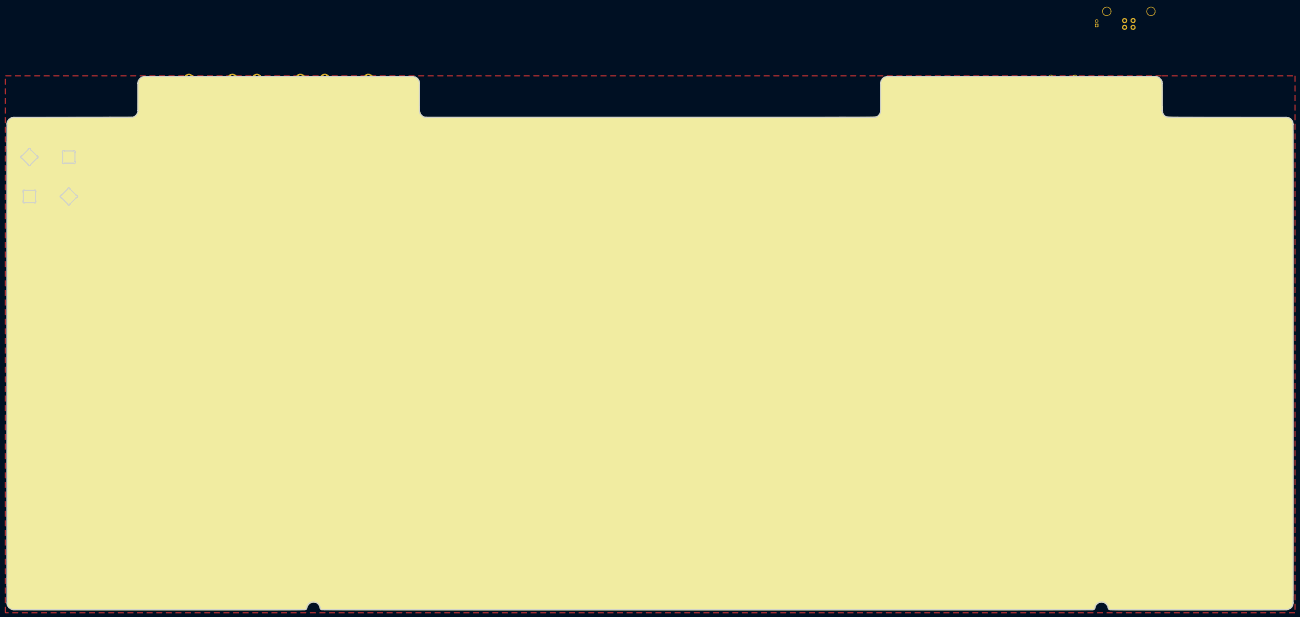
[picture p16: board 1800.kicad_pcb from above]

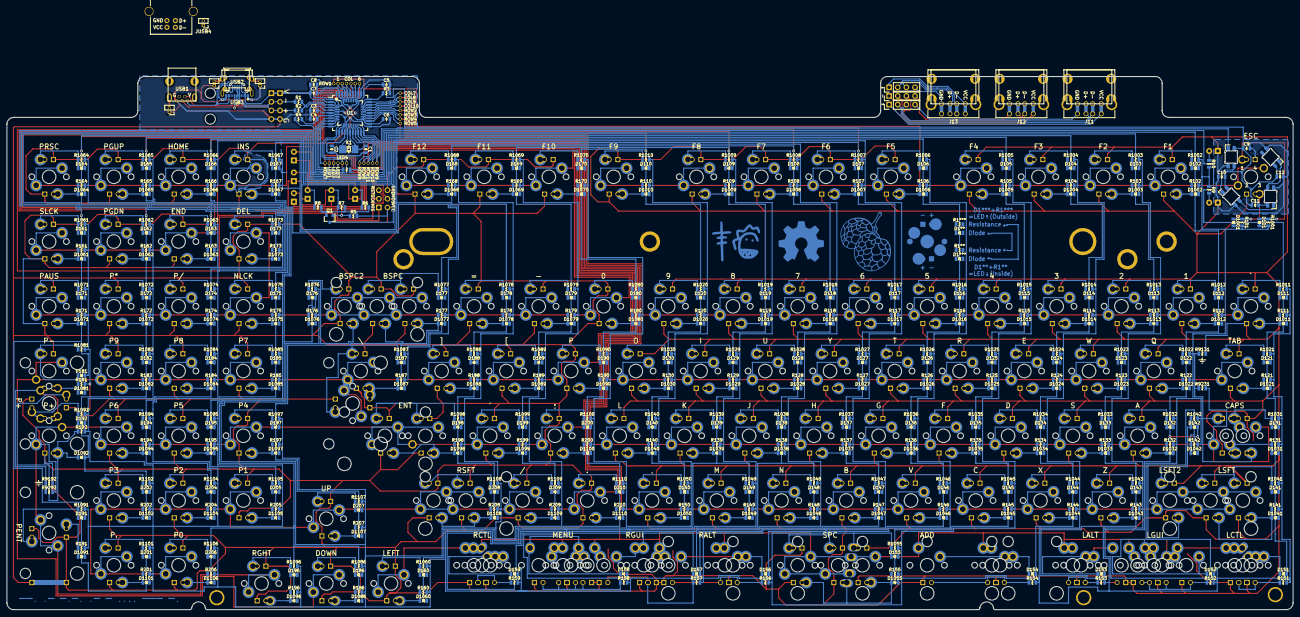
[picture p17: board 1800.kicad_pcb from below]

Board: 2 copper layers, 378.4 x 156.9 mm, 611 parts (461 on the bottom side), 276 nets.

Other parts of the board:
D1**, D1***: D_0805
J1#2: CONN_01X04; Pin_Header_Straight_1x04_Pitch2.54mm
R1**, R1***: R_0805
Ref**: CherryMX; MX1A&LEDx2

Their connections:
/USBD+: J1#2.3; also elsewhere on the board
/USBD-: J1#2.2; also elsewhere on the board
GND: J1#2.4; also elsewhere on the board
VCC: J1#2.1; also elsewhere on the board
