Gacathon/LeeChee_Mirror/1800transfer/1800transfer.kicad_pcb

## KiCad design 1800transfer/1800transfer.kicad_pcb (2017-11-04)

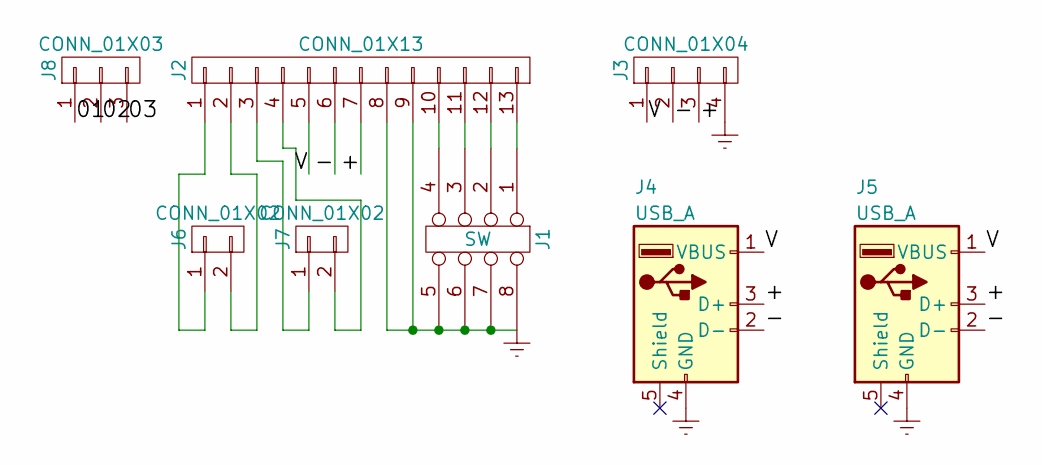
[picture p18: schematic 1800transfer.sch]

Parts:
J1: SW; SW_DIP_x4_W7.62mm_Slide_LowProfile
J2: CONN_01X13; Pin_Header_Straight_1x13_Pitch2.54mm
J3: CONN_01X04; Pin_Header_Straight_1x04_Pitch2.54mm
J4, J5: USB_A
J6, J7: CONN_01X02; Pin_Header_Straight_1x02_Pitch2.54mm
J8: CONN_01X03; Pin_Header_Straight_1x03_Pitch2.54mm

Connections:
/01: J8.1
/02: J8.2
/03: J8.3
/+: J2.7, J3.3, J4.3 (D+), J5.3 (D+)
/-: J2.6, J3.2, J4.2 (D-), J5.2 (D-)
/V: J2.5, J3.1, J4.1 (VBUS), J5.1 (VBUS)
Earth: J1.5, J1.6, J1.7, J1.8, J2.8, J2.9, J3.4, J4.4 (GND), J5.4 (GND)
unnamed: J1.1, J2.13
unnamed: J1.2, J2.12
unnamed: J1.3, J2.11
unnamed: J1.4, J2.10
unnamed: J2.1, J6.1
unnamed: J2.2, J6.2
unnamed: J2.3, J7.1
unnamed: J2.4, J7.2

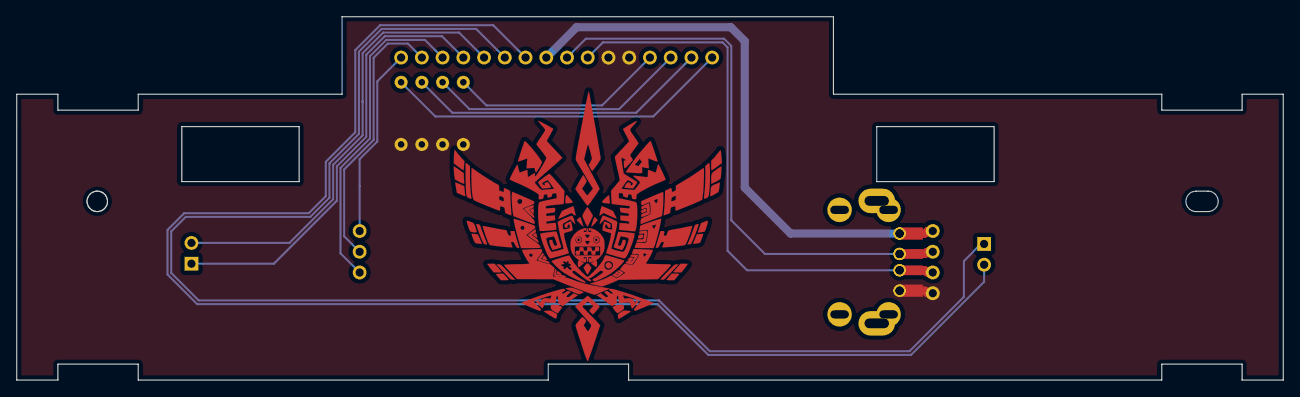
[picture p19: board 1800transfer.kicad_pcb from above]

Board: 2 copper layers, 155.1 x 44.5 mm, 8 parts (1 on the bottom side), 12 nets.
